mihaigalos/DotStix/hardware/DotStix.brd

## EAGLE design hardware/DotStix.brd (2019-07-21)

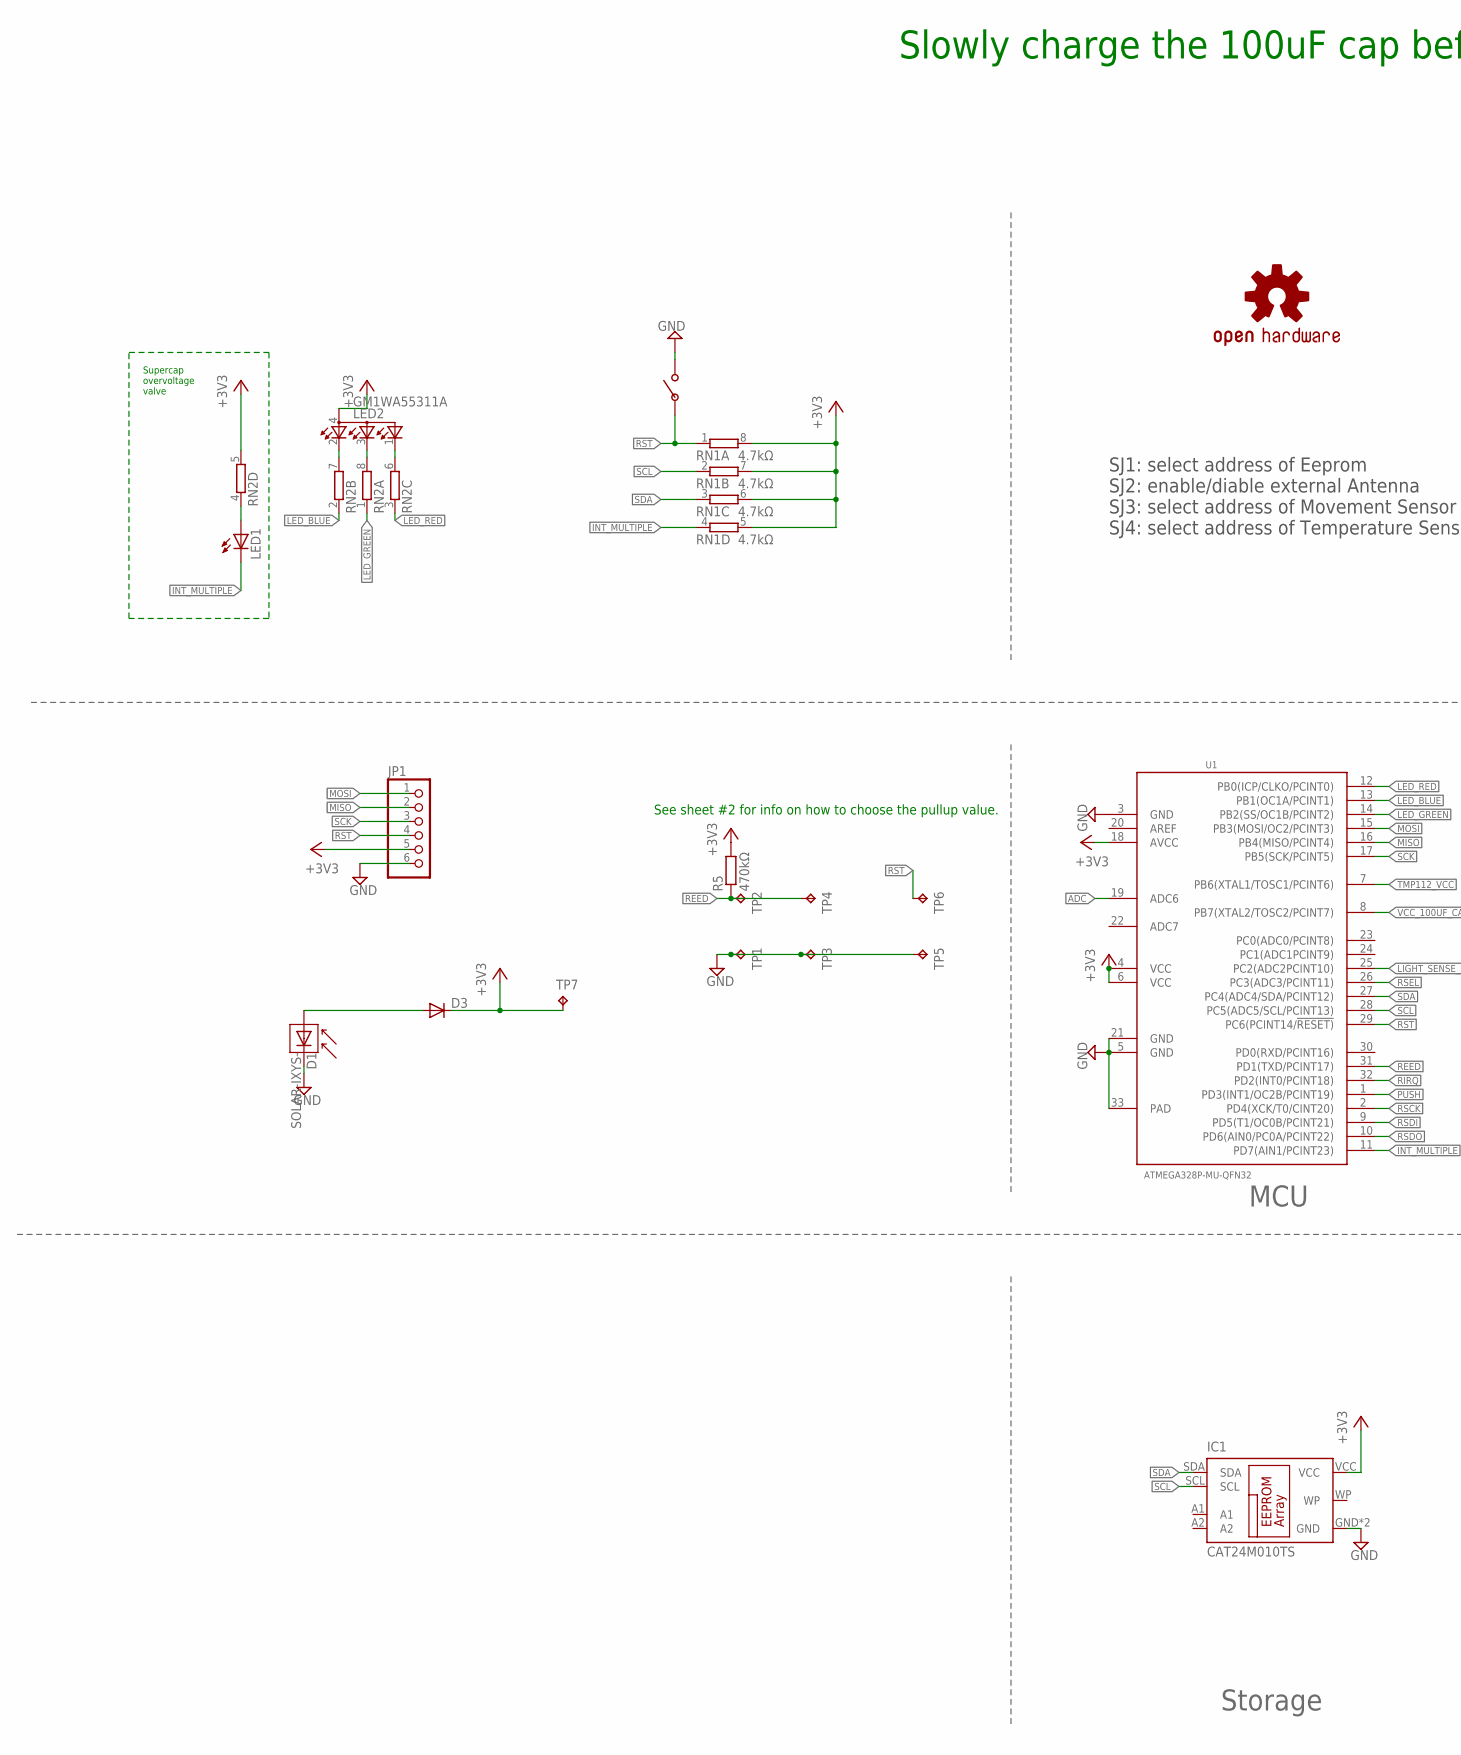
[picture p1: schematic DotStix.sch, sheet 1, part in row 1, column 1]

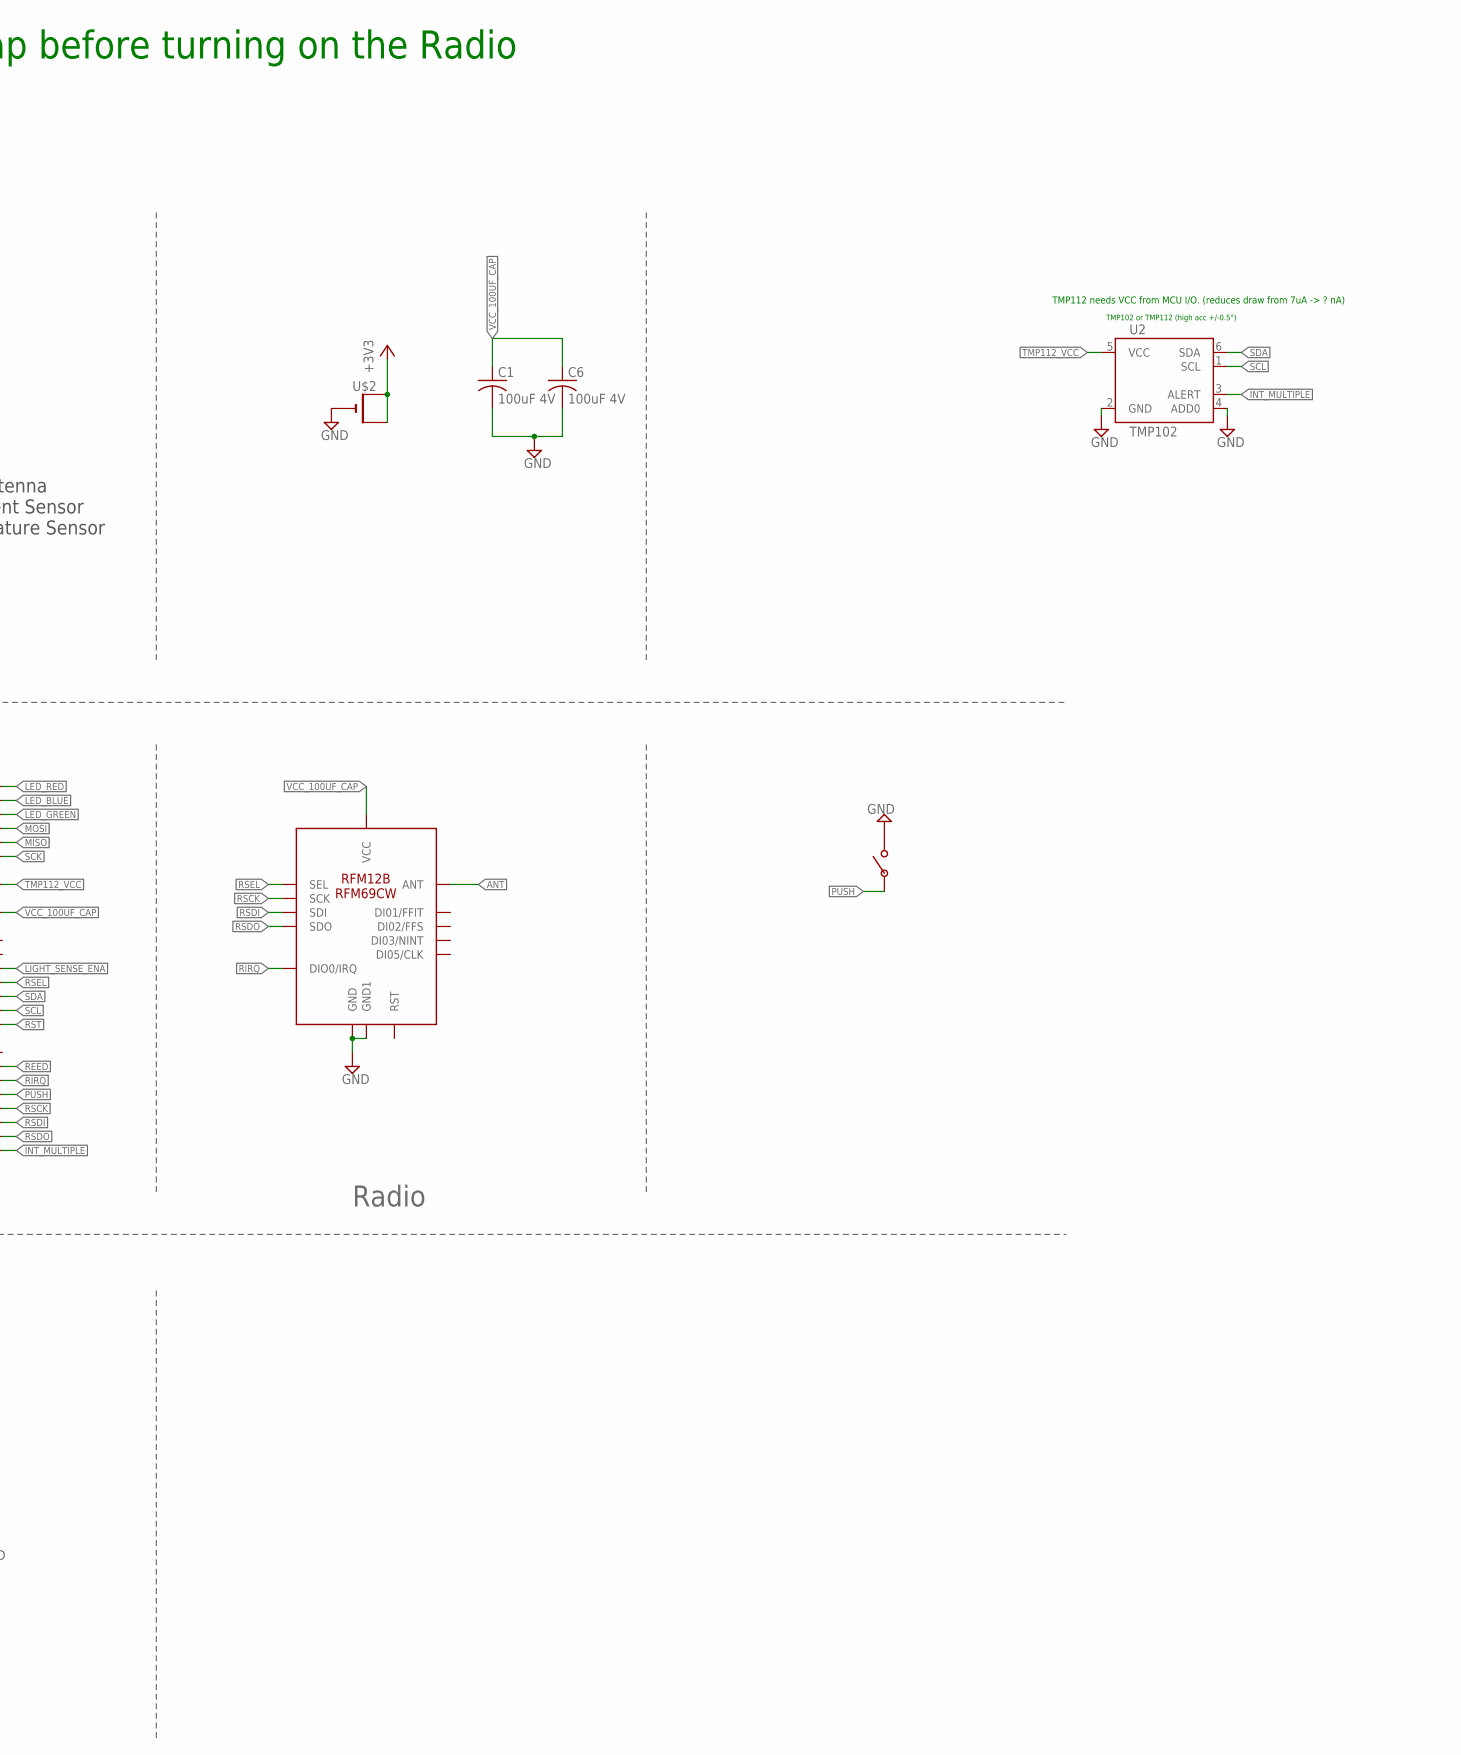
[picture p2: schematic DotStix.sch, sheet 1, part in row 1, column 2]

Parts:
C1, C6: 100uF 4V; C3216
D1: SOLAR-IXYS-; SOLARBIT-12X1
D3: DIODE-SOD523; SOD523
IC1: CAT24M010TS; TSSOP8
JP1: PINHD-1X6; 1X06
LED1: LEDCHIP-LED0603; CHIP-LED0603
LED2: GM1WA55311A
LOGO1: OSHW-LOGOS; OSHW-LOGO-S
R5: 470kΩ; R0603
RN1: 4.7kΩ; 4X0402ARV341
RN2: 4R-N0402ARV341; 4X0402ARV341
TP1, TP2, TP3, TP4, TP5, TP6, TP7: TPTP20SQ; TP20SQ
U1: ATMEGA328P-MU-QFN32; QFN32G-0.5-5X5MM
U2: TMP102; SOT563
U$1: RFM12B/69CW
U$2: CR1220SMT; CR1220-SMD
U$3, U$4: PUSHBUTTON_4X2.5

Connections:
+3V3: D3.C, IC1.VCC, JP1.5, LED2.4 (A), R5.2, RN1.5 (2), RN1.6 (2), RN1.7 (2), RN1.8 (2), RN2.5 (2), TP7.TP, U1.4 (VCC), U1.6 (VCC), U1.18 (AVCC), U$2.+$1 (+), U$2.+$2 (+1)
ADC: U1.19 (ADC6)
ANT: U$1.ANT
GND: C1.2, C6.2, D1.- (C), IC1.GND, IC1.NC (GND), JP1.6, TP1.TP, TP3.TP, TP5.TP, U1.3 (GND), U1.5 (GND), U1.21 (GND), U1.33 (PAD), U2.2 (GND), U2.4 (ADD0), U$1.GND, U$1.GND1, U$2.-, U$3.P$2, U$4.P$2
INT_MULTIPLE: LED1.C, RN1.4 (1), U1.11 (PD7(AIN1/PCINT23)), U2.3 (ALERT)
LED_BLUE: RN2.2 (1), U1.13 (PB1(OC1A/PCINT1))
LED_GREEN: RN2.1, U1.14 (PB2(SS/OC1B/PCINT2))
LED_RED: RN2.3 (1), U1.12 (PB0(ICP/CLKO/PCINT0))
LIGHT_SENSE_ENA: U1.25 (PC2(ADC2PCINT10))
MISO: JP1.2, U1.16 (PB4(MISO/PCINT4))
MOSI: JP1.1, U1.15 (PB3(MOSI/OC2/PCINT3))
unnamed: LED2.2 (CRED), RN2.7 (2)
unnamed: D1.+ (A), D3.A
unnamed: LED2.3 (CBLUE), RN2.8 (2)
unnamed: LED2.1 (CGREEN), RN2.6 (2)
unnamed: LED1.A, RN2.4 (1)
PUSH: U1.1 (PD3(INT1/OC2B/PCINT19)), U$4.P$1
REED: R5.1, TP2.TP, TP4.TP, U1.31 (PD1(TXD/PCINT17))
RIRQ: U1.32 (PD2(INT0/PCINT18)), U$1.IRQ (DIO0/IRQ)
RSCK: U1.2 (PD4(XCK/T0/CINT20)), U$1.SCK
RSDI: U1.9 (PD5(T1/OC0B/PCINT21)), U$1.SDI
RSDO: U1.10 (PD6(AIN0/PC0A/PCINT22)), U$1.SDO
RSEL: U1.26 (PC3(ADC3/PCINT11)), U$1.SEL
RST: JP1.4, RN1.1, TP6.TP, U1.29 (PC6(PCINT14/!RESET)), U$3.P$1
SCK: JP1.3, U1.17 (PB5(SCK/PCINT5))
SCL: IC1.SCL, RN1.2 (1), U1.28 (PC5(ADC5/SCL/PCINT13)), U2.1 (SCL)
SDA: IC1.SDA, RN1.3 (1), U1.27 (PC4(ADC4/SDA/PCINT12)), U2.6 (SDA)
TMP112_VCC: U1.7 (PB6(XTAL1/TOSC1/PCINT6)), U2.5 (VCC)
VCC_100UF_CAP: C1.1, C6.1, U1.8 (PB7(XTAL2/TOSC2/PCINT7)), U$1.VDD (VCC)

Notes on the sheet:
SJ1: select address of Eeprom SJ2: enable/diable external Antenna SJ3: select address of Movement Sensor SJ4: select address of Temperature Sensor
MCU
Radio
See sheet #2 for info on how to choose the pullup value.
TMP102 or TMP112 (high acc +/-0.5°)
Storage
TMP112 needs VCC from MCU I/O. (reduces draw from 7uA -> ? nA)
Slowly charge the 100uF cap before turning on the Radio
Supercap overvoltage valve

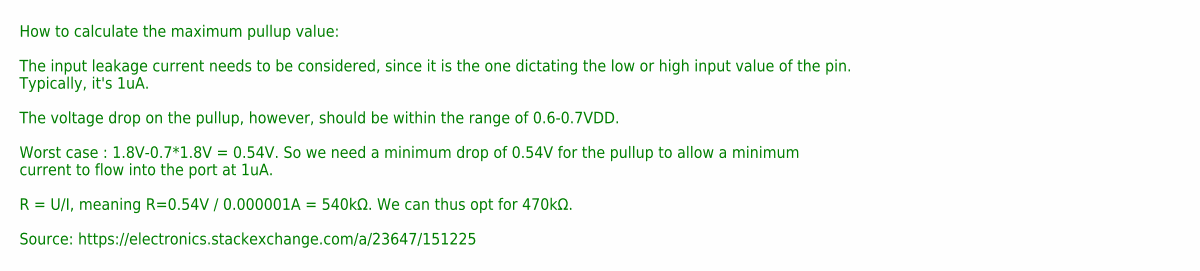
[picture p3: schematic DotStix.sch, sheet 2]

Notes on the sheet:
How to calculate the maximum pullup value: The input leakage current needs to be considered, since it is the one dictating the low or high input value of the pin. Typically, it's 1uA. The voltage drop on the pullup, however, should be within the range of 0.6-0.7VDD. Worst case : 1.8V-0.7*1.8V = 0.5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

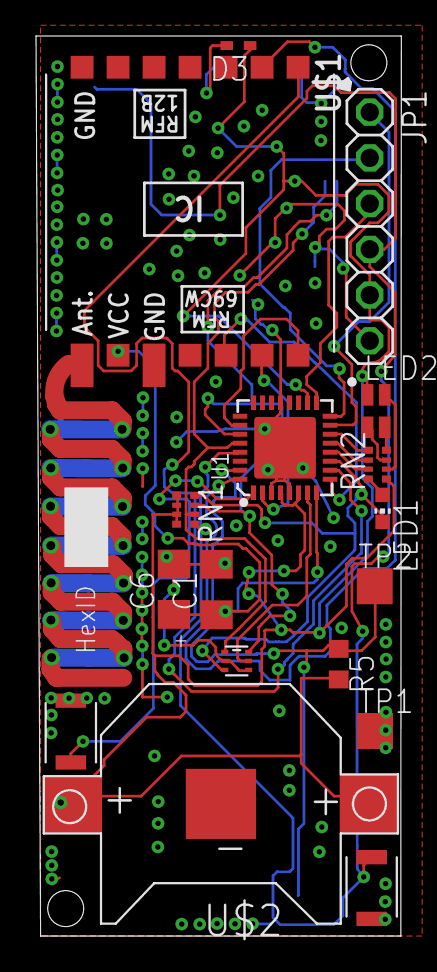
[picture p4: board DotStix.brd from above]

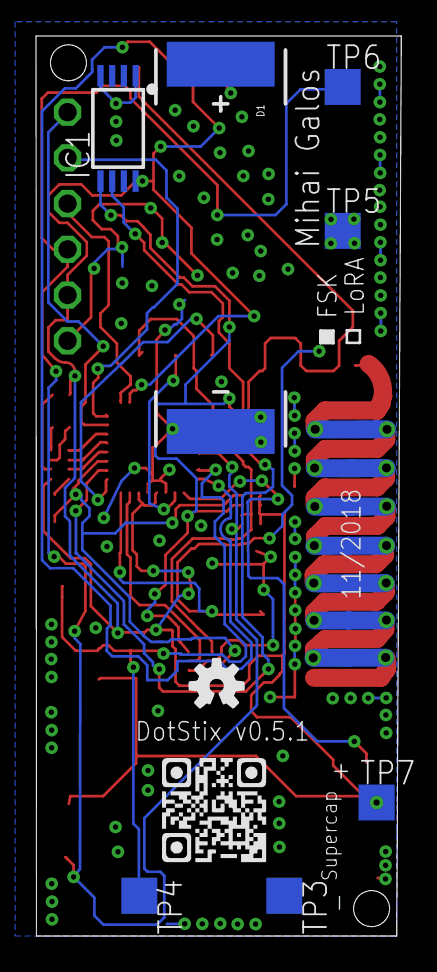
[picture p5: board DotStix.brd from below]

Board: 2 copper layers, 20.3 x 50.0 mm, 25 parts (8 on the bottom side), 26 nets.
