mihaigalos/DotStix/(commit log)

2018-01-03 Add QR, labels, heavy GND, reposition battery
    [DotStix.brd]
2018-01-03 Add reed switch
    [DotStix.brd, DotStix.sch]
2018-01-03 Add polarity to 100uF cap
    [DotStix.brd]
2018-01-03 Add key for MOSI, adjust R-array vias
    [DotStix.brd]
2018-01-03 Add RST switch
    [DotStix.brd, DotStix.sch]
2018-01-03 Major rework, add solar cell
    [DotStix.brd, DotStix.sch]
2018-01-03 Add HexID, second reed on rear side
    [DotStix.brd, DotStix.sch]
2018-01-03 Add photoresistor
    [DotStix.brd, DotStix.sch]
2018-01-04 Minor info improvements
    [DotStix.brd, DotStix.sch]
2018-01-04 Draft: Fix solar polarity, add 20ppm crystal
    [DotStix.brd, DotStix.sch]
2018-01-04 Fix solar polarity, add 20ppm crystal
    [DotStix.brd]
2018-01-04 Update version info
    [DotStix.brd]
2018-01-04 Rearrange pin connections around MCU
    [DotStix.brd]
2018-01-04 Readjust vias
    [DotStix.brd]
2018-01-04 Add battery polarity logos
    [DotStix.brd]
2018-01-05 Add weak pullup for low current with battery
    [DotStix.brd, DotStix.sch]
2018-01-05 Add 100uF cap
    [DotStix.brd, DotStix.sch]
2018-01-06 Exp: Add Temp & UV sensors
    [DotStix.brd, DotStix.sch]
2018-01-06 Add via restrict to corners of MCU
    [DotStix.brd]
2018-01-06 Draft : first routing
    [DotStix.brd]
2018-01-06 Finished integration of Temp and UV sensors
    [DotStix.brd, DotStix.sch]
2018-01-06 Move fast signals away from underneath XTAL
    [DotStix.brd]
2018-01-06 Fix unconnected 4.7k pullups
    [DotStix.brd, DotStix.sch]
2018-01-06 Draft: add 9DoF motion sensor
    [DotStix.brd, DotStix.sch]
2018-01-06 Draft: 9DoF pins connected, need to fix warnings
    [DotStix.brd, DotStix.sch]
2018-01-06 Add 9Dof: removed warnings
    [DotStix.brd]
2018-01-06 Move solar panel further away from UV sensor
    [DotStix.brd]
2018-01-06 Adjust author name position
    [DotStix.brd]
2018-01-07 Add 256kb EEPROM
    [DotStix.brd, DotStix.sch]
2018-01-16 Add reed switch for RST. Required for potting
    [DotStix.brd, DotStix.sch]
2018-01-16 Increment version, rearrange text
    [DotStix.brd]
2018-01-31 Modify pullup value for reed, add explanation
    [DotStix.brd, DotStix.sch]
2018-01-31 Remove unnecessary solder jumper
    [DotStix.brd, DotStix.sch]
2018-02-08 Move 3V3 Zener to low side of Schottky
    [DotStix.brd, DotStix.sch]
2018-09-30 Add infos to minimize power
    [DotStix.brd, DotStix.sch]
2018-09-30 Add NMOS to minimize leakage through 100uF cap
    [DotStix.brd, DotStix.sch]
2018-09-30 Cleanup unused, improve GND
    [DotStix.brd, DotStix.sch]
2018-09-30 Increase version
    [DotStix.brd]
2018-09-30 Update version, remove superfluous doc
    [DotStix.brd]
2018-09-30 Remove NMOSFET, connect 100uF to IO directly
    [DotStix.brd, DotStix.sch]
2018-10-18 Led on INT_MULTIPLE, tStop for Supercap GND
    [DotStix.brd, DotStix.sch]
2018-10-18 Update descriptions
    [DotStix.sch]
2018-10-18 Move tStop downstream from battery holder
    [DotStix.brd]
2018-10-18 Add second 100uF cap for RF
    [DotStix.brd, DotStix.sch]
2018-10-19 Duplicate battery pads to tBottom for supercap
    [DotStix.brd]
2019-07-21 Correct supercap pad, add labels for radio & supercap
    [DotStix.brd, DotStix.sch]
2019-07-21 Shift supercap pad to exterior
    [DotStix.brd]
